baobrien/coin-thing/pcb/coin-thingus/coin-trunker.pdf

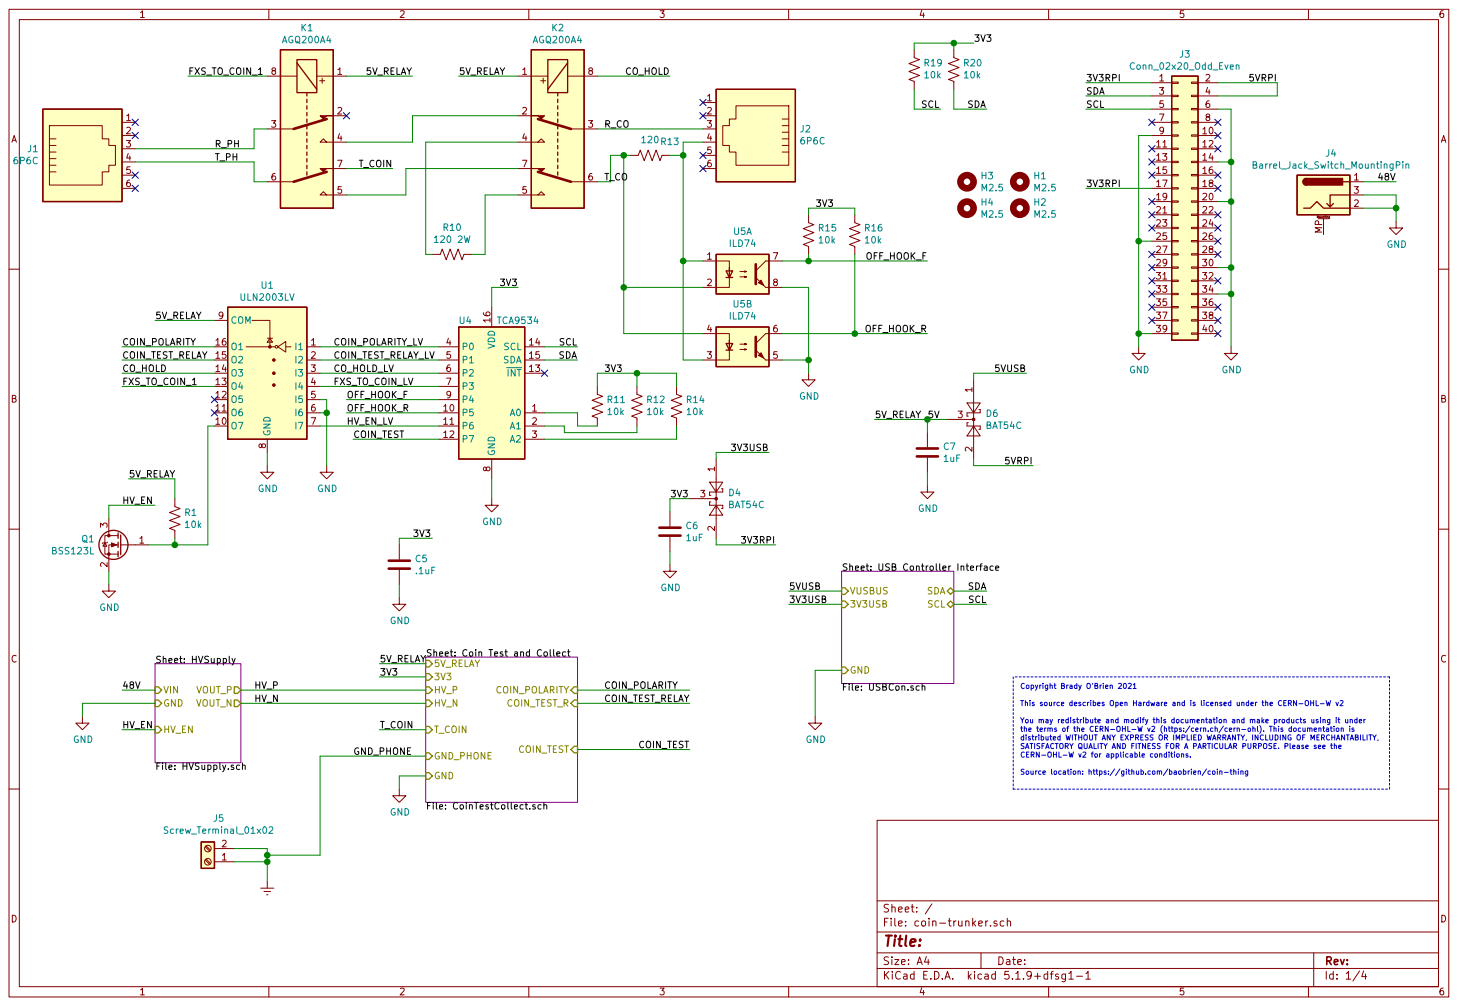
[picture p1: page 1]

Sheet: USB Controller Interface File: USBCon.sch VUSBUS GND

SCL Sheet: Coin Test and Collect File: CoinTestCollect.sch HV_P HV_N

Id: 1/4 Title: File: coin-trunker.sch Sheet: / Sheet: HVSupply

Copyright Brady OBrien 2021 This source describes Open Hardware and is licensed under the CERN-OHL-W v2 You may redistribute and modify this documentation and make products using it under

the terms of the CERN-OHL-W v2 (https:/cern.ch/cern-ohl). This documentation is distributed WITHOUT ANY EXPRESS OR IMPLIED WARRANTY, INCLUDING OF MERCHANTABILITY, SATISFACTORY QUALITY AND FITNESS FOR A PARTICULAR PURPOSE. Please see the CERN-OHL-W v2 for applicable conditions. Source location: https://github.com/baobrien/coin-thing

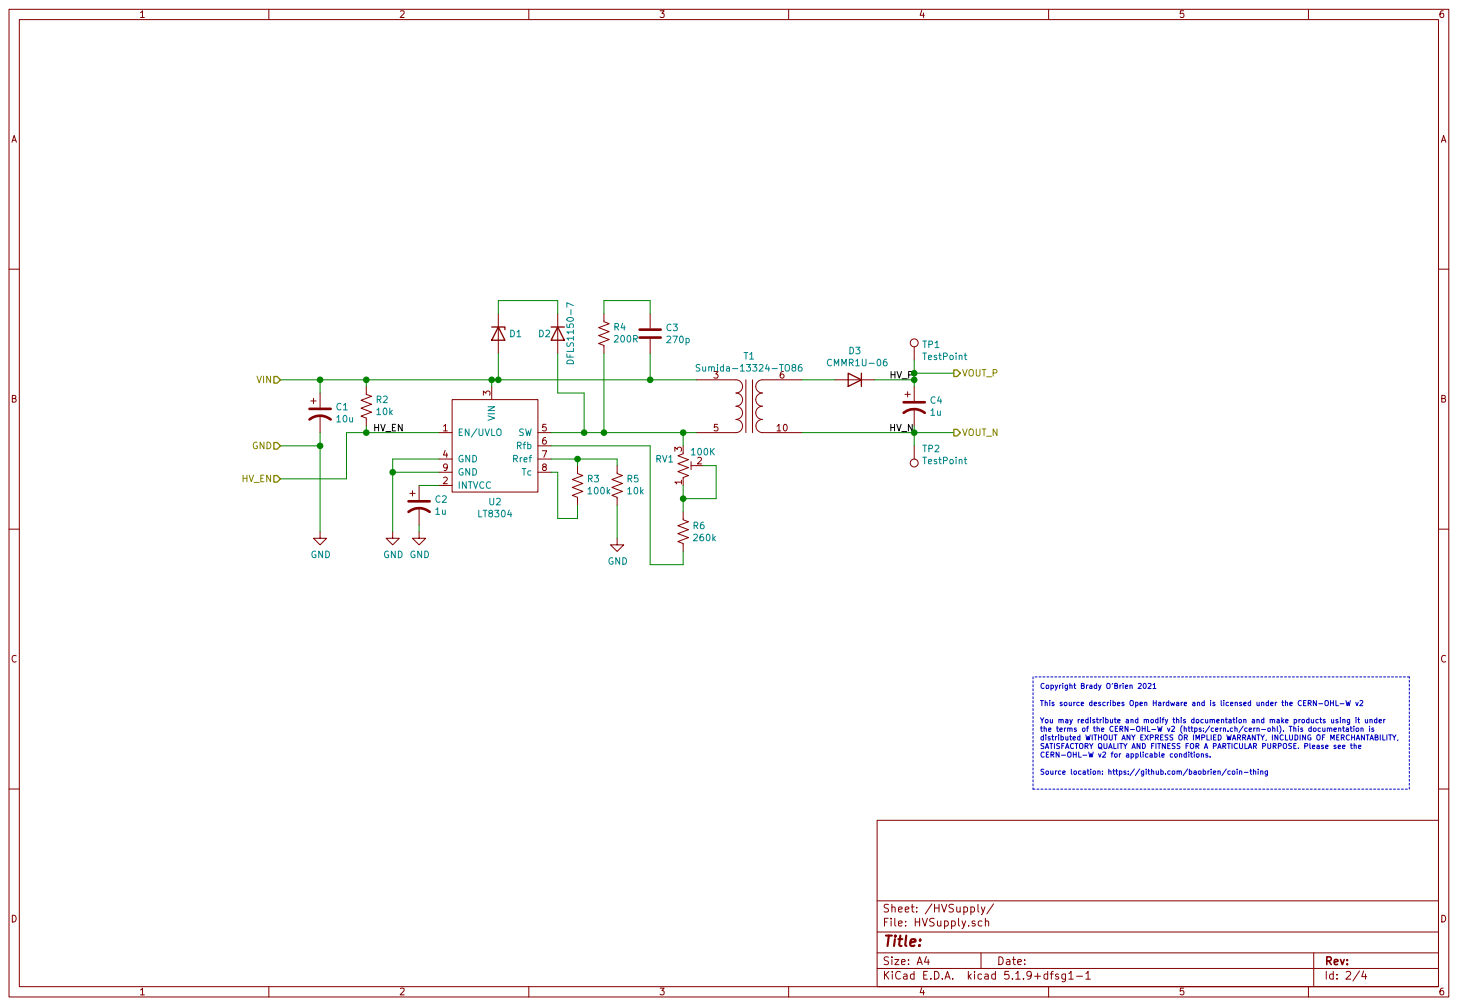
[picture p2: page 2]

3 GND 4 SW 5 Rfb 6 Rref 7 Tc 8 GND 9 U2

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

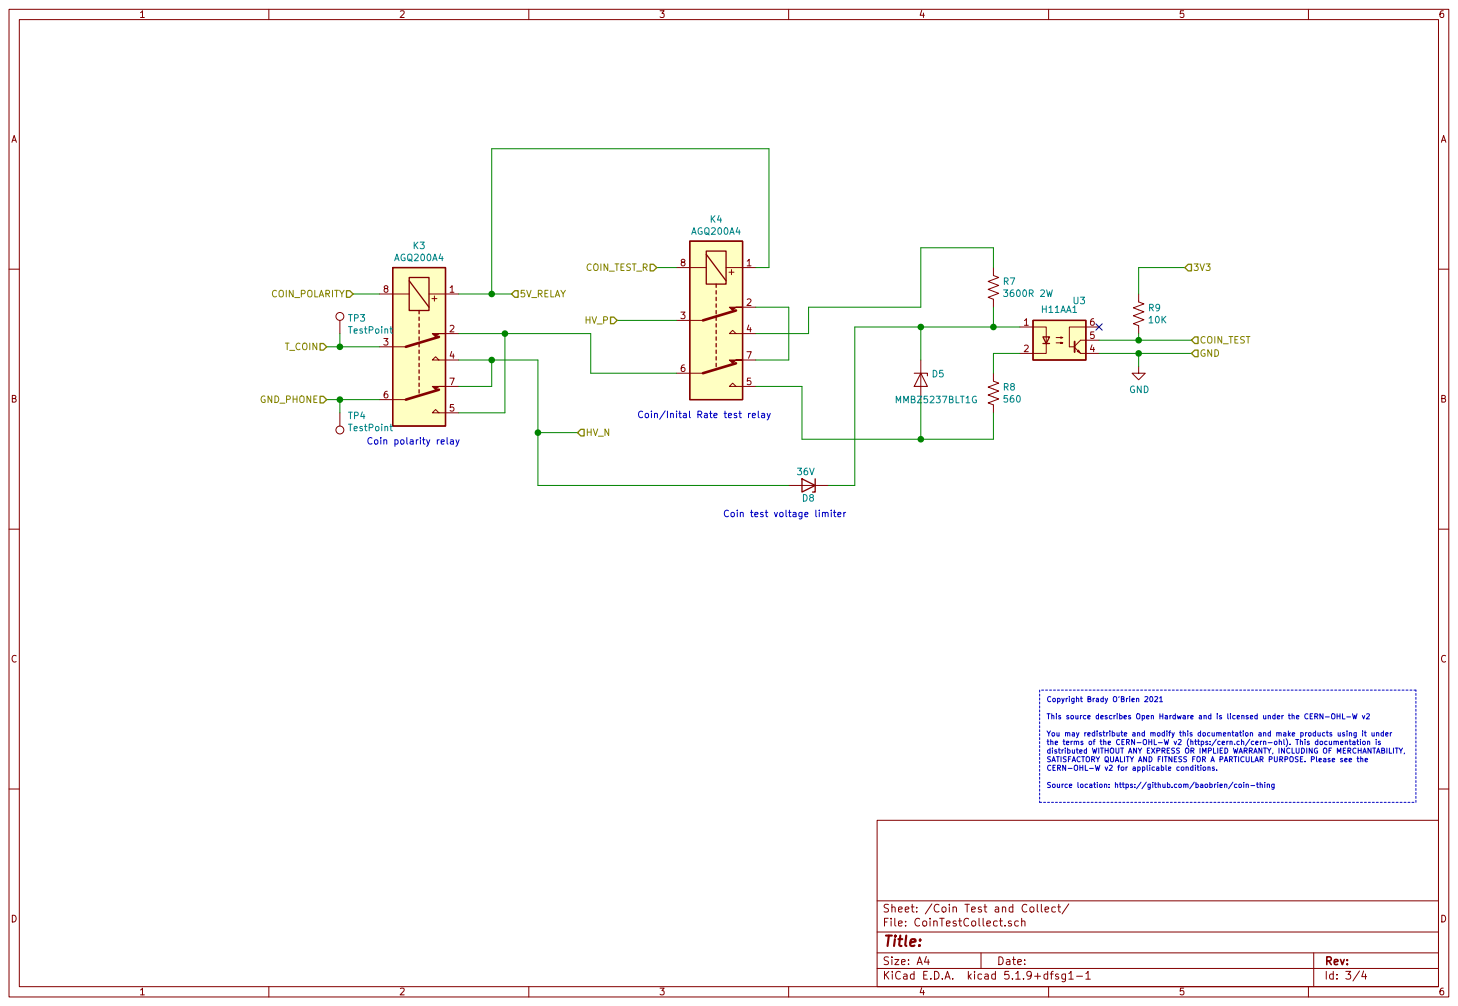
[picture p3: page 3]

Coin/Inital Rate test relay

the terms of the CERN-OHL-W v2 (https:/cern.ch/cern-ohl). This documentation is distributed WITHOUT ANY EXPRESS OR IMPLIED WARRANTY, INCLUDING OF MERCHANTABILITY, SATISFACTORY QUALITY AND FITNESS FOR A PARTICULAR PURPOSE. Please see the CERN-OHL-W v2 for applicable conditions. Source location: https://github.com/baobrien/coin-thing Coin test voltage limiter

Id: 3/4 Title: File: CoinTestCollect.sch Sheet: /Coin Test and Collect/

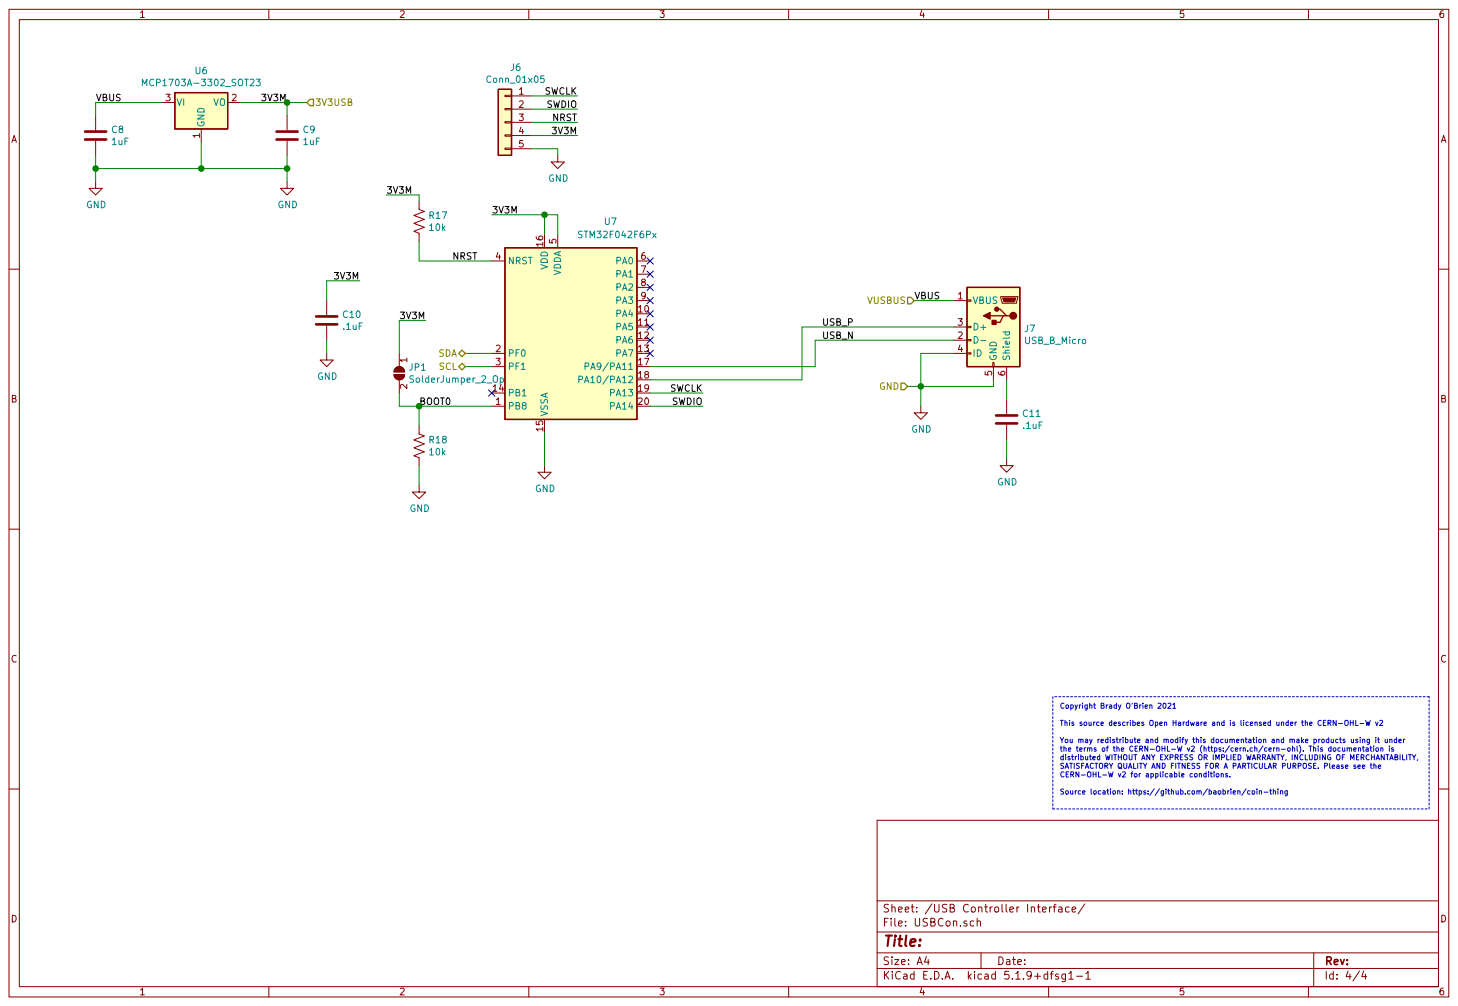
[picture p4: page 4]
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

Id: 4/4 Title: File: USBCon.sch Sheet: /USB Controller Interface/
