baobrien/coin-thing/(list of files, drawings)

Other design files:
pcb/coin-thingus/coin-trunker.dsn
