baobrien/coin-thing/pcb/coin-thingus/coin-trunker.kicad_pcb

## KiCad design pcb/coin-thingus/coin-trunker.kicad_pcb (2021-04-16)

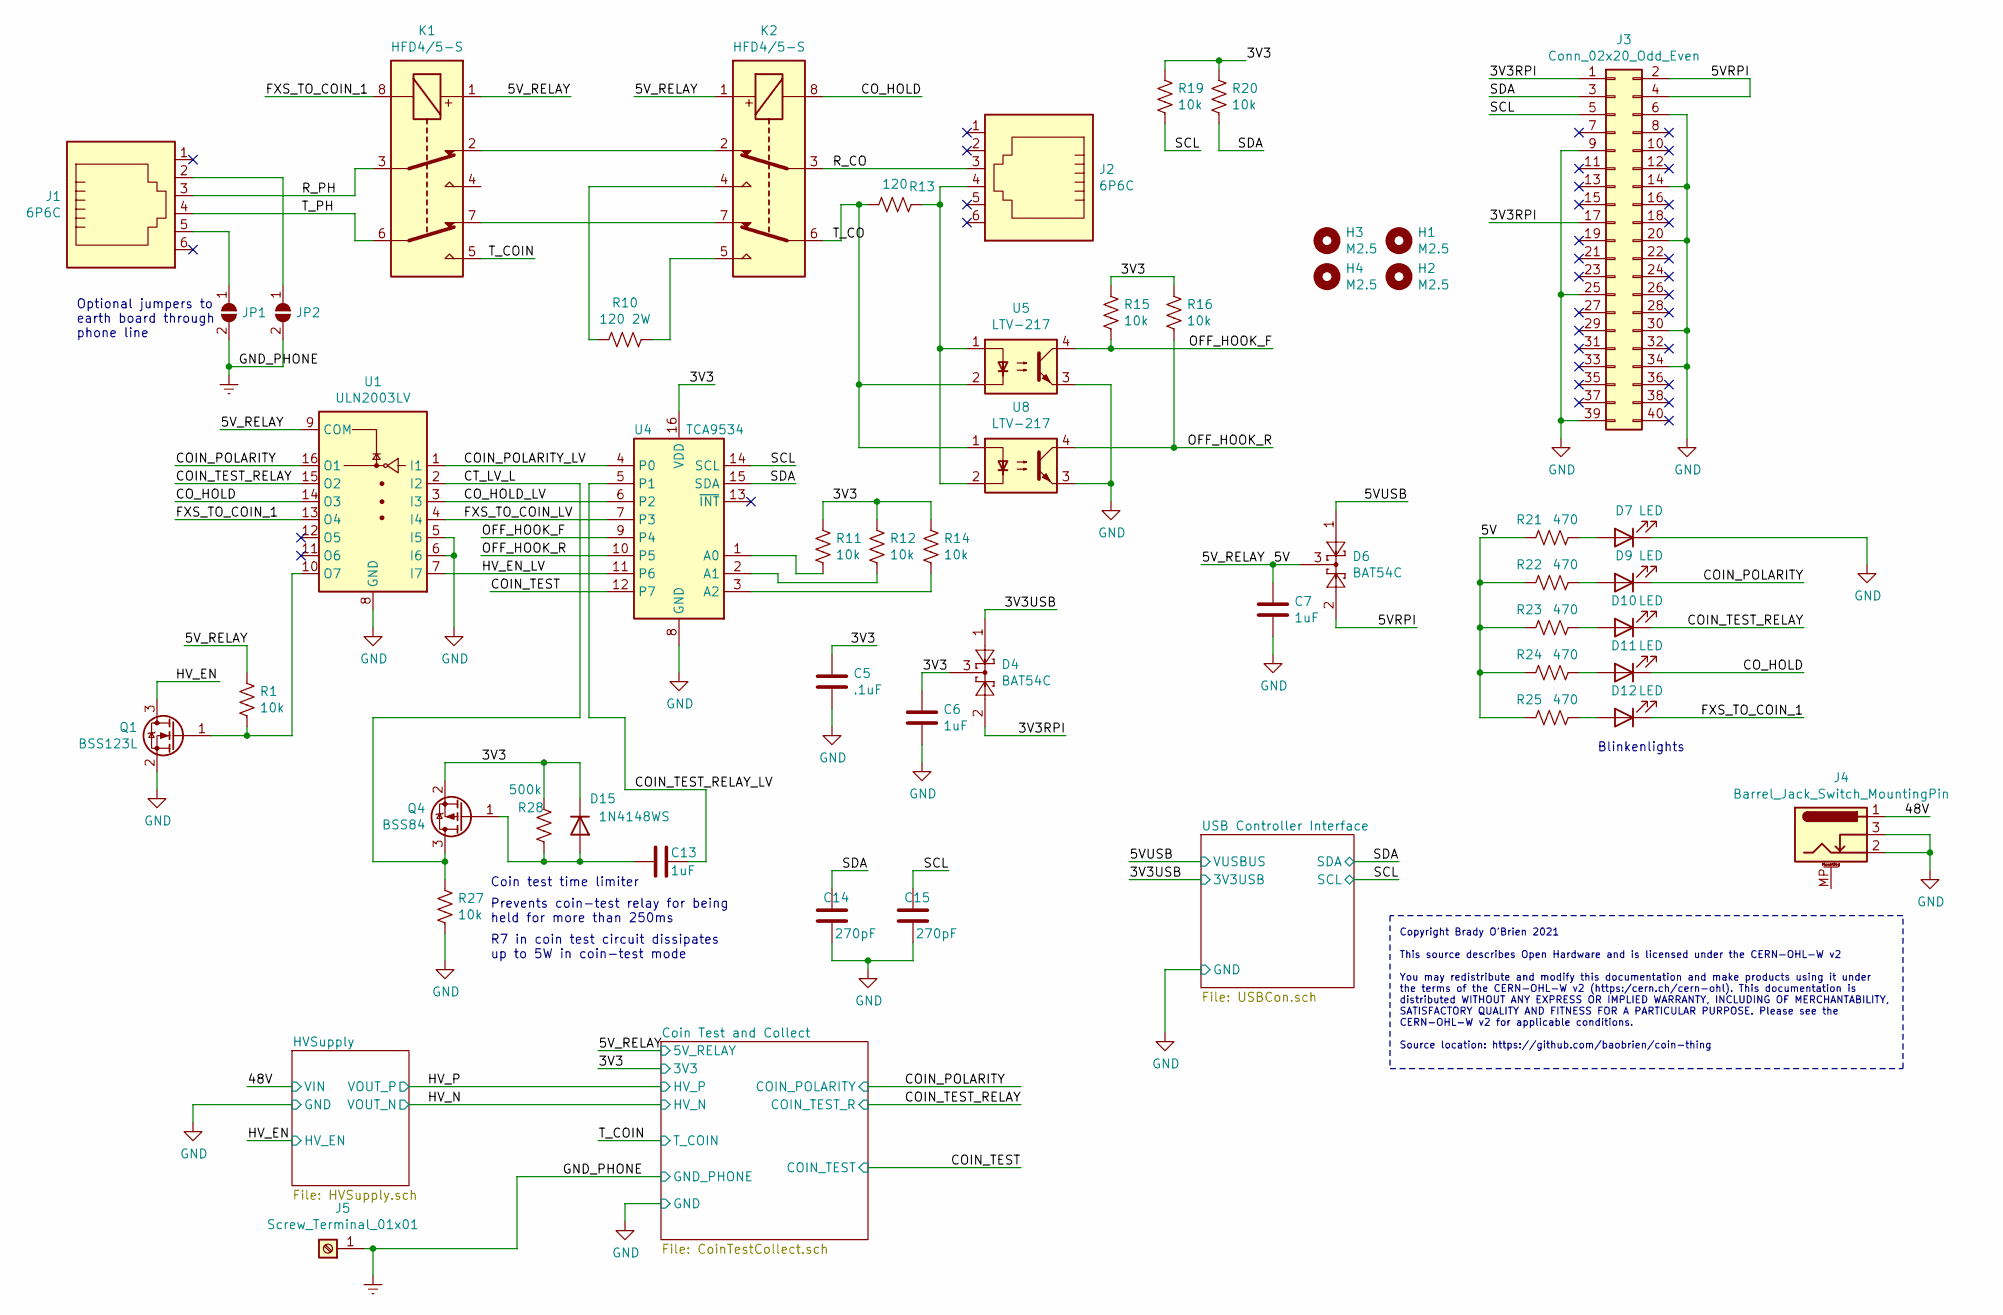
[picture p5: schematic coin-trunker.sch]

Parts:
C5: .1uF; C_0603_1608Metric
C6, C7, C13: 1uF; C_0603_1608Metric
C14, C15: 270pF; C_0603_1608Metric
D4, D6: BAT54C; SOT-23
D7, D9, D10, D11, D12: LED; LED_0603_1608Metric
D15: 1N4148WS; D_SOD-323_HandSoldering
H1, H2, H3, H4: M2.5; MountingHole_2.7mm_M2.5_Pad
J1, J2: 6P6C; RJ12_Molex_95501-6669
J3: Conn_02x20_Odd_Even; PinHeader_2x20_P2.54mm_Vertical
J4: Barrel_Jack_Switch_MountingPin; BarrelJack_CUI_PJ-102AH_Horizontal; Part PJ-102AH
J5: Screw_Terminal_01x01; screw_block_m3_5x7
JP1, JP2: SolderJumper_2_Open; SolderJumper-2_P1.3mm_Open_TrianglePad1.0x1.5mm
K1, K2: HFD4/5-S; Relay_DPDT_Omron_G6K-2F-Y
Q1: BSS123L; SOT-23
Q4: BSS84; SOT-23
R1, R11, R12, R14, R15, R16, R19, R20, R27: 10k; R_0402_1005Metric
R10: 120 2W; R_1206_3216Metric
R13: 120; R_0402_1005Metric
R21, R22, R23, R24, R25: 470; R_0402_1005Metric
R28: 500k; R_0402_1005Metric
U1: ULN2003LV; SOIC-16_3.9x9.9mm_P1.27mm
U4: TCA9534; TSSOP-16_4.4x5mm_P0.65mm
U5, U8: LTV-217; SOP-4_4.4x2.6mm_P1.27mm

Connections:
/3V3: C5.1, C6.1, D4.3, D15.1 (K), Q4.2 (S), R11.2, R12.2, R14.2, R15.2, R16.2, R19.2, R20.2, R28.1, U4.16 (VDD); also elsewhere on the board
/3V3RPI: D4.2, J3.1, J3.17
/3V3USB: D4.1; also elsewhere on the board
/5V: C7.1, D6.3, K1.1, K2.1, R1.1, R21.2, R22.2, R23.2, R24.2, R25.2, U1.9 (COM); also elsewhere on the board
/5VRPI: D6.2, J3.2, J3.4
/5VUSB: D6.1; also elsewhere on the board
/48V: J4.1; also elsewhere on the board
/COIN_POLARITY: D9.1 (K), U1.16 (O1); also elsewhere on the board
/COIN_POLARITY_LV: U1.1 (I1), U4.4 (P0)
/COIN_TEST: U4.12 (P7); also elsewhere on the board
/COIN_TEST_RELAY: D10.1 (K), U1.15 (O2); also elsewhere on the board
/COIN_TEST_RELAY_LV: C13.1, U4.5 (P1)
/CO_HOLD: D11.1 (K), K2.8, U1.14 (O3)
/CO_HOLD_LV: U1.3 (I3), U4.6 (P2)
/CT_LV_L: Q4.3 (D), R27.1, U1.2 (I2)
/FXS_TO_COIN_1: D12.1 (K), K1.8, U1.13 (O4)
/FXS_TO_COIN_LV: U1.4 (I4), U4.7 (P3)
/HV_EN: Q1.3 (D); also elsewhere on the board
/HV_EN_LV: U1.7 (I7), U4.11 (P6)
/OFF_HOOK_F: R15.1, U4.9 (P4), U5.4
/OFF_HOOK_R: R16.1, U4.10 (P5), U8.4
/R_CO: J2.3, K2.3
/R_PH: J1.3, K1.3
/SCL: C15.2, J3.5, R19.1, U4.14 (SCL); also elsewhere on the board
/SDA: C14.2, J3.3, R20.1, U4.15 (SDA); also elsewhere on the board
/T_CO: K2.6, R13.1, U5.2, U8.1
/T_COIN: K1.5; also elsewhere on the board
/T_PH: J1.4, K1.6
Earth: J5.1, JP1.2 (B), JP2.2 (B); also elsewhere on the board
GND: C5.2, C6.2, C7.2, C14.1, C15.1, D7.1 (K), J3.6, J3.9, J3.14, J3.20, J3.25, J3.30, J3.34, J3.39, J4.2, J4.3, Q1.2 (S), R27.2, U1.5 (I5), U1.6 (I6), U1.8 (GND), U4.8 (GND), U5.3, U8.3; also elsewhere on the board
unnamed: C13.2, D15.2 (A), Q4.1 (G), R28.2
unnamed: D7.2 (A), R21.1
unnamed: D9.2 (A), R22.1
unnamed: D10.2 (A), R23.1
unnamed: D11.2 (A), R24.1
unnamed: D12.2 (A), R25.1
unnamed: J1.2, JP2.1 (A)
unnamed: J1.5, JP1.1 (A)
unnamed: J2.4, R13.2, U5.1, U8.2
unnamed: K1.2, K2.2
unnamed: K1.7, K2.7
unnamed: K2.4, R10.2
unnamed: K2.5, R10.1
unnamed: Q1.1 (G), R1.2, U1.10 (O7)
unnamed: R11.1, U4.1 (A0)
unnamed: R12.1, U4.2 (A1)
unnamed: R14.1, U4.3 (A2)

Notes on the sheet:
Copyright Brady O’Brien 2021 This source describes Open Hardware and is licensed under the CERN-OHL-W v2 You may redistribute and modify this documentation and make products using it under the terms of the CERN-OHL-W v2 (https:/cern.ch/cern-ohl). This documentation is distributed WITHOUT ANY EXPRES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
Blinkenlights
Optional jumpers to earth board through phone line
Coin test time limiter
Prevents coin-test relay for being held for more than 250ms
R7 in coin test circuit dissipates up to 5W in coin-test mode

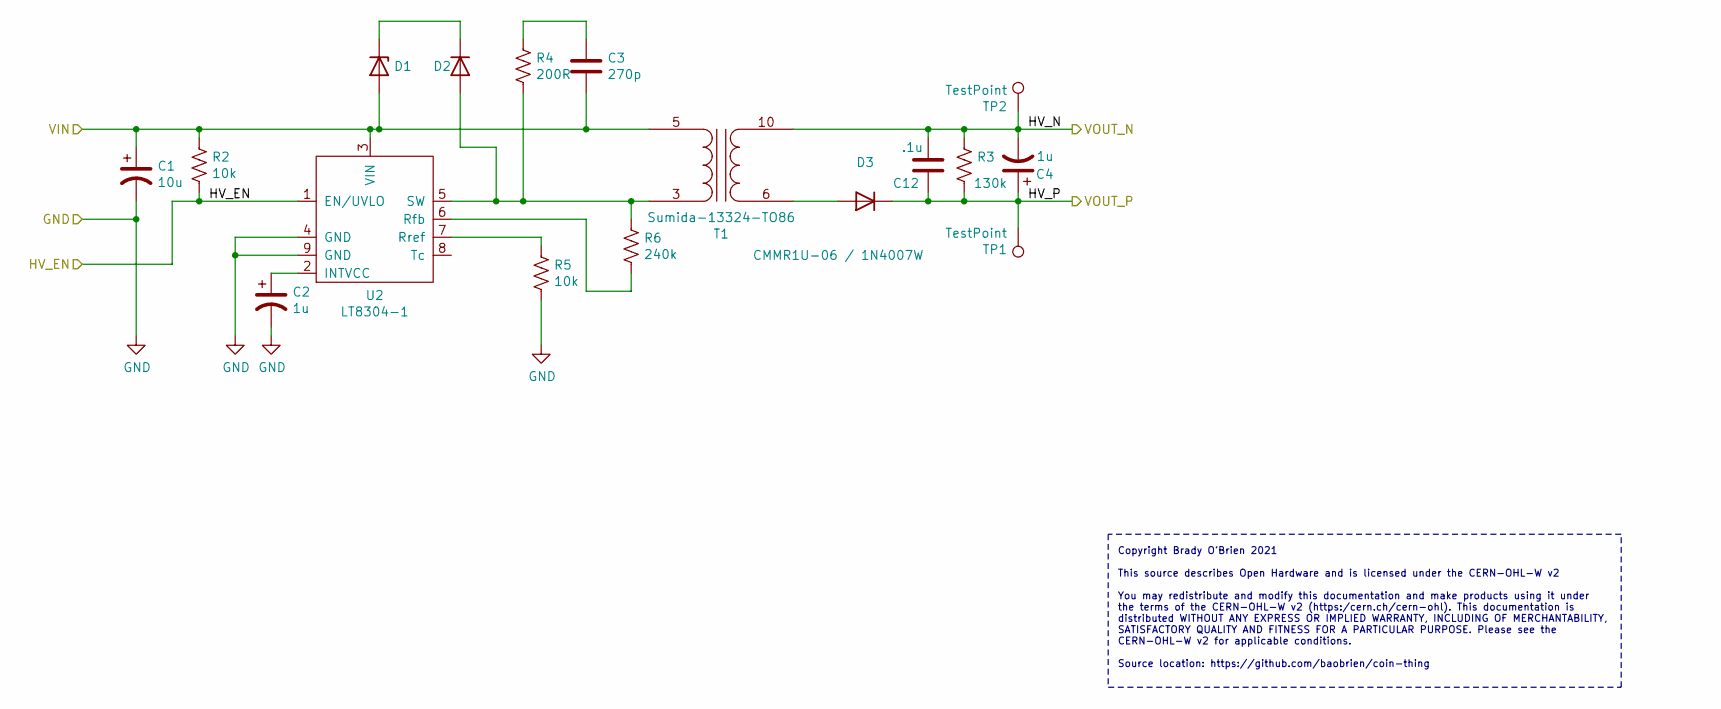
[picture p6: schematic HVSupply.sch]

Parts:
C1: 10u; C_1210_3225Metric
C2: 1u; C_0603_1608Metric
C3: 270p; C_0603_1608Metric
C4: 1u; CP_Radial_D6.3mm_P2.50mm
C12: .1u; C_1210_3225Metric
D1: D_Zener; D_SMA
D2: DFLS1150-7; D_PowerDI-123
D3: CMMR1U-06 / 1N4007W; D_SOD-123F; Part CMMR1U-06
R2, R5: 10k; R_0402_1005Metric
R3: 130k; R_0402_1005Metric
R4: 200R; R_0402_1005Metric
R6: 240k; R_0603_1608Metric
T1: Sumida-13324-TO86; SUMIDA-S-074-1511
TP1, TP2: TestPoint; Pin_D1.0mm_L10.0mm
U2: LT8304-1; TI_SO-PowerPAD-8

Connections:
/48V: C1.1, C3.2, D1.2 (A), R2.2, T1.5 (AB), U2.3 (VIN); also elsewhere on the board
/HV_EN: R2.1, U2.1 (EN/UVLO); also elsewhere on the board
/HV_N: C4.2, C12.1, R3.1, T1.10 (SA), TP2.1; also elsewhere on the board
/HV_P: C4.1, C12.2, D3.1 (K), R3.2, TP1.1; also elsewhere on the board
GND: C1.2, C2.2, R5.1, U2.4 (GND), U2.9 (GND); also elsewhere on the board
unnamed: C2.1, U2.2 (INTVCC)
unnamed: C3.1, R4.2
unnamed: D1.1 (K), D2.1 (K)
unnamed: D2.2 (A), R4.1, R6.1, T1.3 (AA), U2.5 (SW)
unnamed: D3.2 (A), T1.6 (SB)
unnamed: R5.2, U2.7 (Rref)
unnamed: R6.2, U2.6 (Rfb)

Notes on the sheet:
Copyright Brady O’Brien 2021 This source describes Open Hardware and is licensed under the CERN-OHL-W v2 You may redistribute and modify this documentation and make products using it under the terms of the CERN-OHL-W v2 (https:/cern.ch/cern-ohl). This documentation is distributed WITHOUT ANY EXPRES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

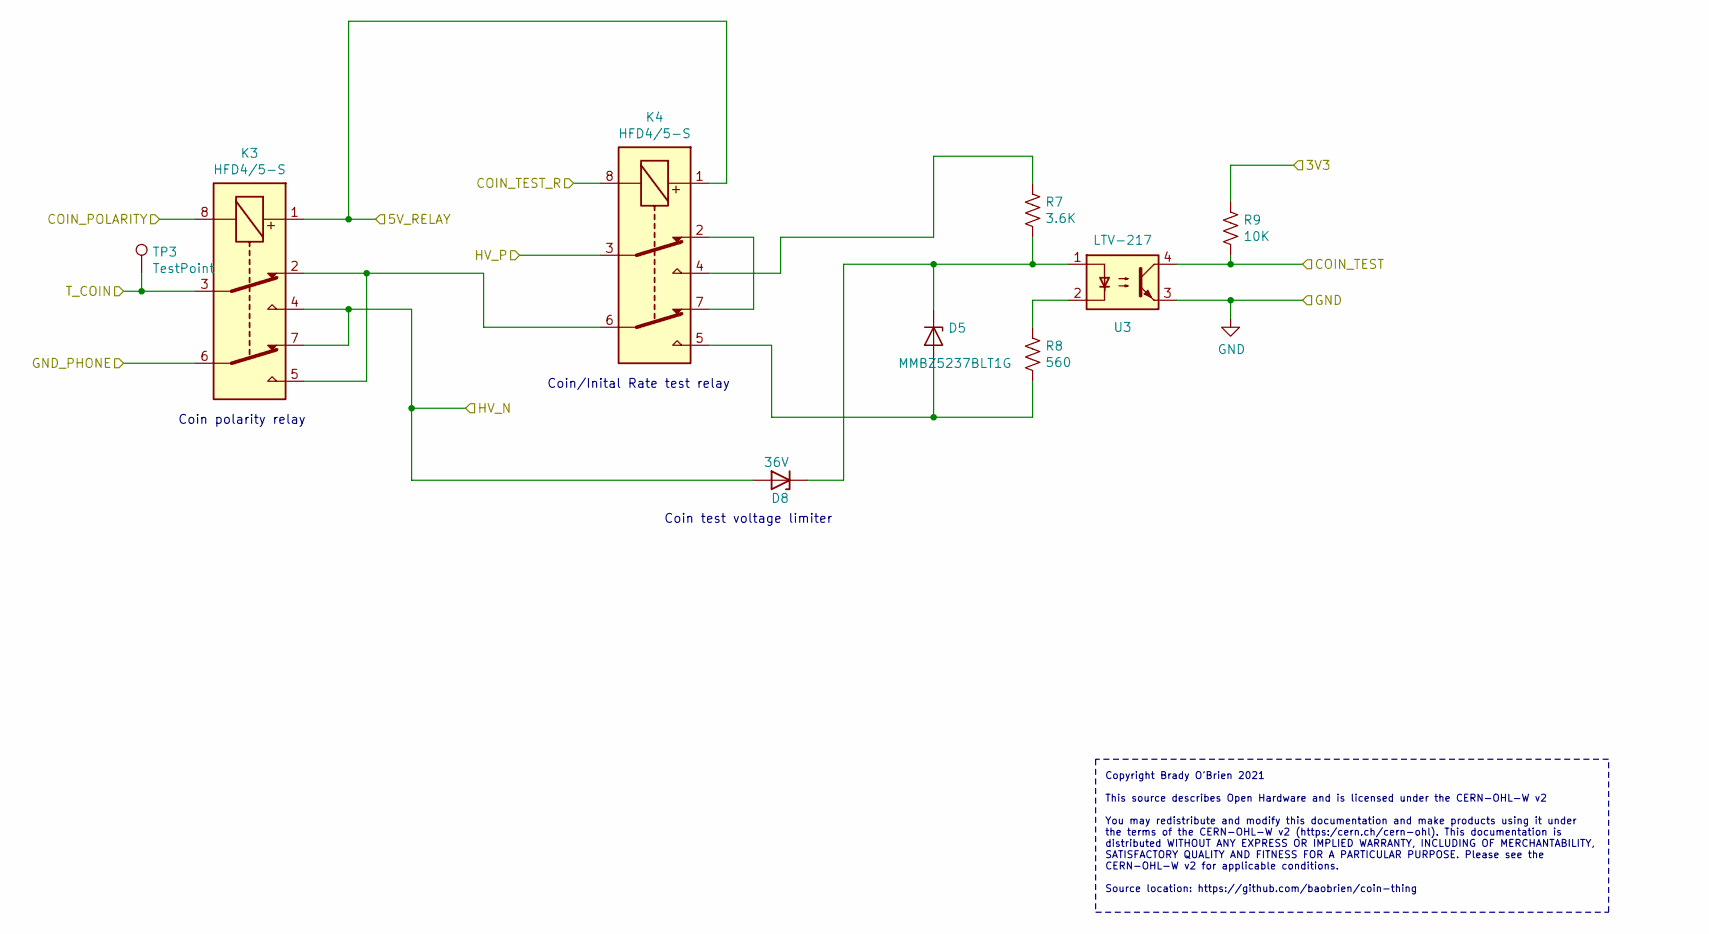
[picture p7: schematic CoinTestCollect.sch]

Parts:
D5: MMBZ5237BLT1G; SOT-23; Part MMBZ5237BLT1G
D8: 36V; D_SOD-323_HandSoldering; Part BZX384-C36
K3, K4: HFD4/5-S; Relay_DPDT_Omron_G6K-2F-Y
R7: 3.6K; R_2010_5025Metric; Part 2010W2J0392T4S
R8: 560; R_0603_1608Metric
R9: 10K; R_0402_1005Metric
TP3: TestPoint; Pin_D1.0mm_L10.0mm
U3: LTV-217; SOP-4_4.4x2.6mm_P1.27mm

Connections:
/3V3: R9.1; also elsewhere on the board
/5V: K3.1, K4.1; also elsewhere on the board
/COIN_POLARITY: K3.8; also elsewhere on the board
/COIN_TEST: R9.2, U3.4; also elsewhere on the board
/COIN_TEST_RELAY: K4.8; also elsewhere on the board
/HV_N: D8.2 (A), K3.4, K3.7; also elsewhere on the board
/HV_P: K4.3; also elsewhere on the board
/T_COIN: K3.3, TP3.1; also elsewhere on the board
Earth: K3.6; also elsewhere on the board
GND: U3.3; also elsewhere on the board
unnamed: D5.1 (A), K4.5, R8.2
unnamed: D5.3 (K), D8.1 (K), R7.2, U3.1
unnamed: K3.2, K3.5, K4.6
unnamed: K4.2, K4.7
unnamed: K4.4, R7.1
unnamed: R8.1, U3.2

Notes on the sheet:
Coin polarity relay
Coin/Inital Rate test relay
Coin test voltage limiter
Copyright Brady O’Brien 2021 This source describes Open Hardware and is licensed under the CERN-OHL-W v2 You may redistribute and modify this documentation and make products using it under the terms of the CERN-OHL-W v2 (https:/cern.ch/cern-ohl). This documentation is distributed WITHOUT ANY EXPRES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

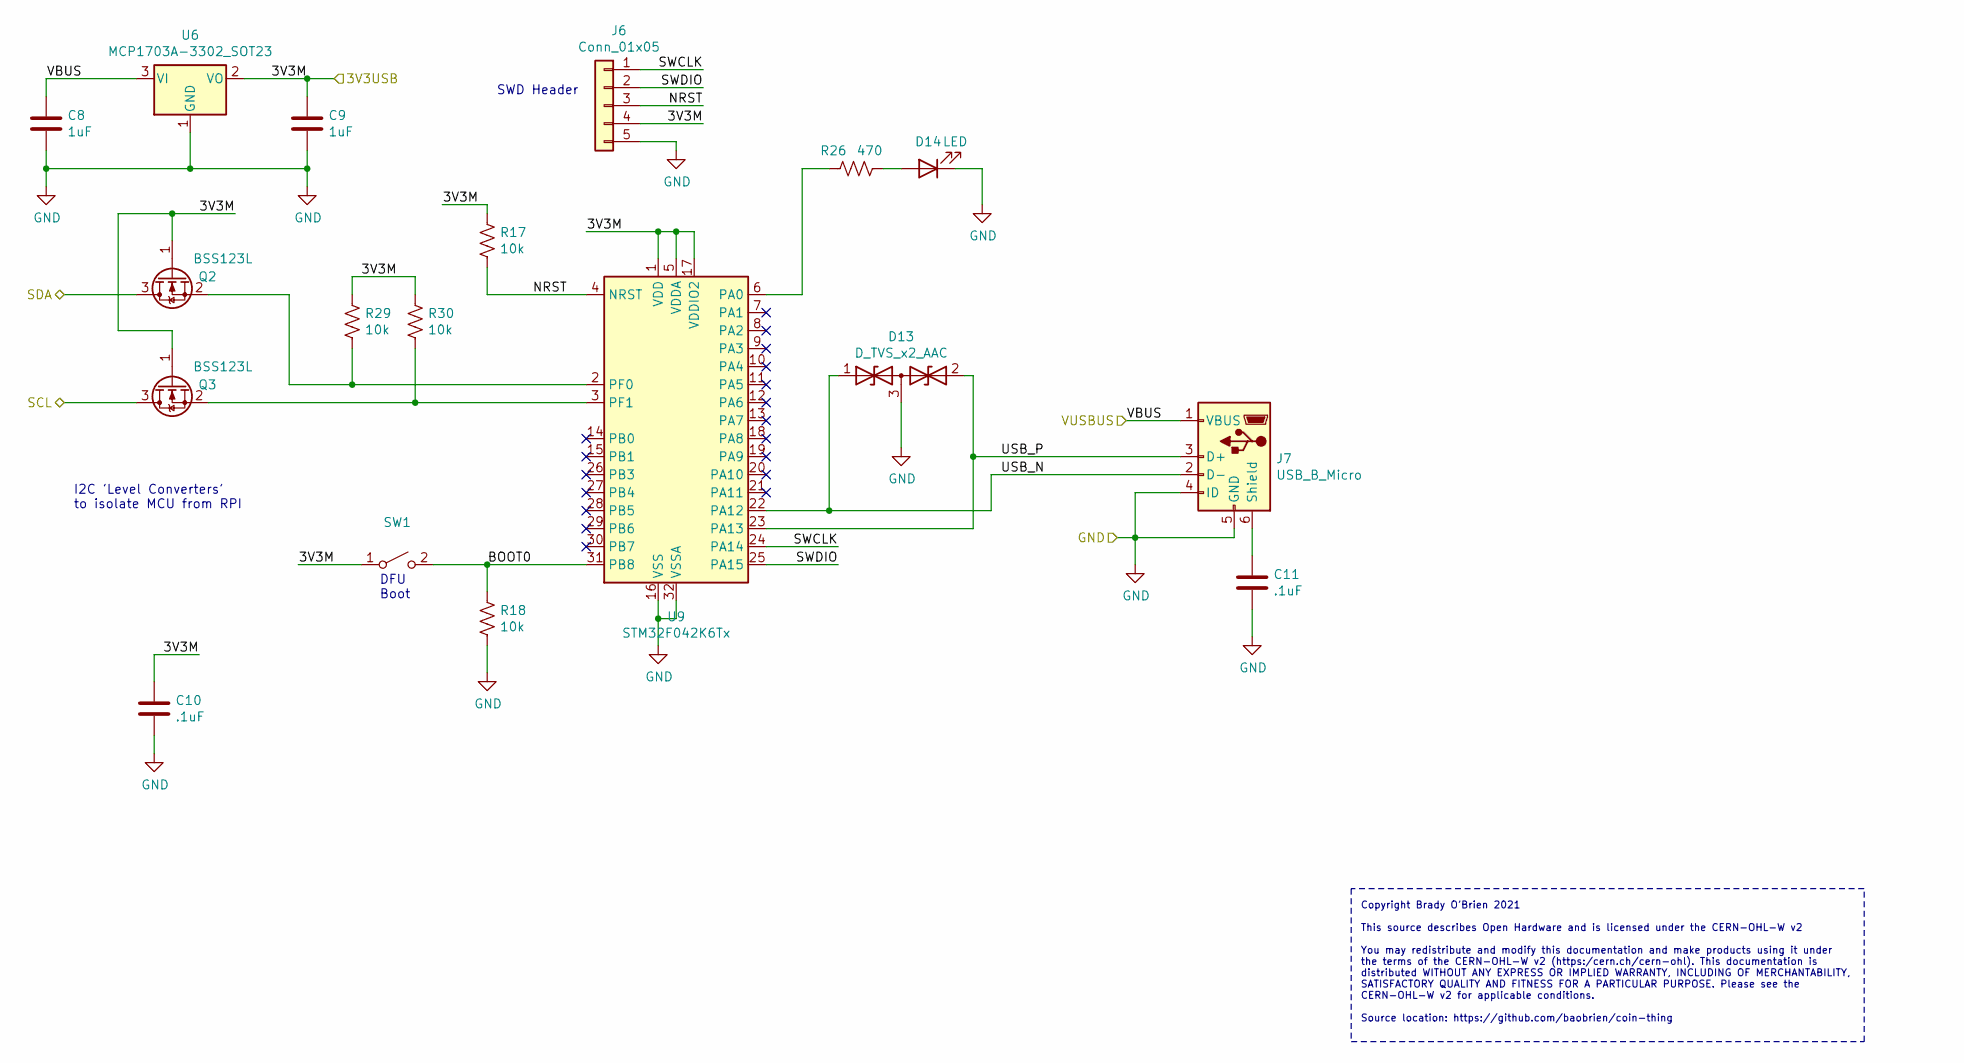
[picture p8: schematic USBCon.sch]

Parts:
C8, C9: 1uF; C_0603_1608Metric
C10, C11: .1uF; C_0603_1608Metric
D13: D_TVS_x2_AAC; SOT-23
D14: LED; LED_0603_1608Metric
J6: Conn_01x05; PinHeader_1x05_P2.54mm_Vertical
J7: USB_B_Micro; USB_Micro-B_Molex-105017-0001; Part U254-051T-4BH23-S2B
Q2, Q3: BSS123L; SOT-23
R17, R18, R29, R30: 10k; R_0402_1005Metric
R26: 470; R_0402_1005Metric
SW1: TS-1187A-C-E-B; SW_SPST_TL3342; Part TS-1187A-C-E-B
U6: MCP1703A-3302_SOT23; SOT-23; Part Alt SC662K-3.3V
U9: STM32F042K6Tx; LQFP-32_7x7mm_P0.8mm

Connections:
/3V3USB: C9.1, C10.1, J6.4, Q2.1 (G), Q3.1 (G), R17.1, R29.1, R30.1, SW1.1 (A), U6.2 (VO), U9.1 (VDD), U9.5 (VDDA), U9.17 (VDDIO2); also elsewhere on the board
/5VUSB: C8.1, J7.1 (VBUS), U6.3 (VI); also elsewhere on the board
/SCL: Q3.3 (D); also elsewhere on the board
/SDA: Q2.3 (D); also elsewhere on the board
/USB Controller Interface/BOOT0: R18.1, SW1.2 (B), U9.31 (PB8)
/USB Controller Interface/NRST: J6.3, R17.2, U9.4 (NRST)
/USB Controller Interface/SWCLK: J6.1, U9.24 (PA14)
/USB Controller Interface/SWDIO: J6.2, U9.25 (PA15)
/USB Controller Interface/USB_N: D13.1 (A1), J7.2 (D-), U9.22 (PA12)
/USB Controller Interface/USB_P: D13.2 (A2), J7.3 (D+), U9.23 (PA13)
GND: C8.2, C9.2, C10.2, C11.2, D13.3 (common), D14.1 (K), J6.5, J7.4 (ID), J7.5 (GND), R18.2, U6.1 (GND), U9.16 (VSS), U9.32 (VSSA); also elsewhere on the board
unnamed: C11.1, J7.6 (Shield)
unnamed: D14.2 (A), R26.1
unnamed: Q2.2 (S), R29.2, U9.2 (PF0)
unnamed: Q3.2 (S), R30.2, U9.3 (PF1)
unnamed: R26.2, U9.6 (PA0)

Notes on the sheet:
Copyright Brady O’Brien 2021 This source describes Open Hardware and is licensed under the CERN-OHL-W v2 You may redistribute and modify this documentation and make products using it under the terms of the CERN-OHL-W v2 (https:/cern.ch/cern-ohl). This documentation is distributed WITHOUT ANY EXPRES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
DFU Boot
SWD Header
I2C 'Level Converters' to isolate MCU from RPI

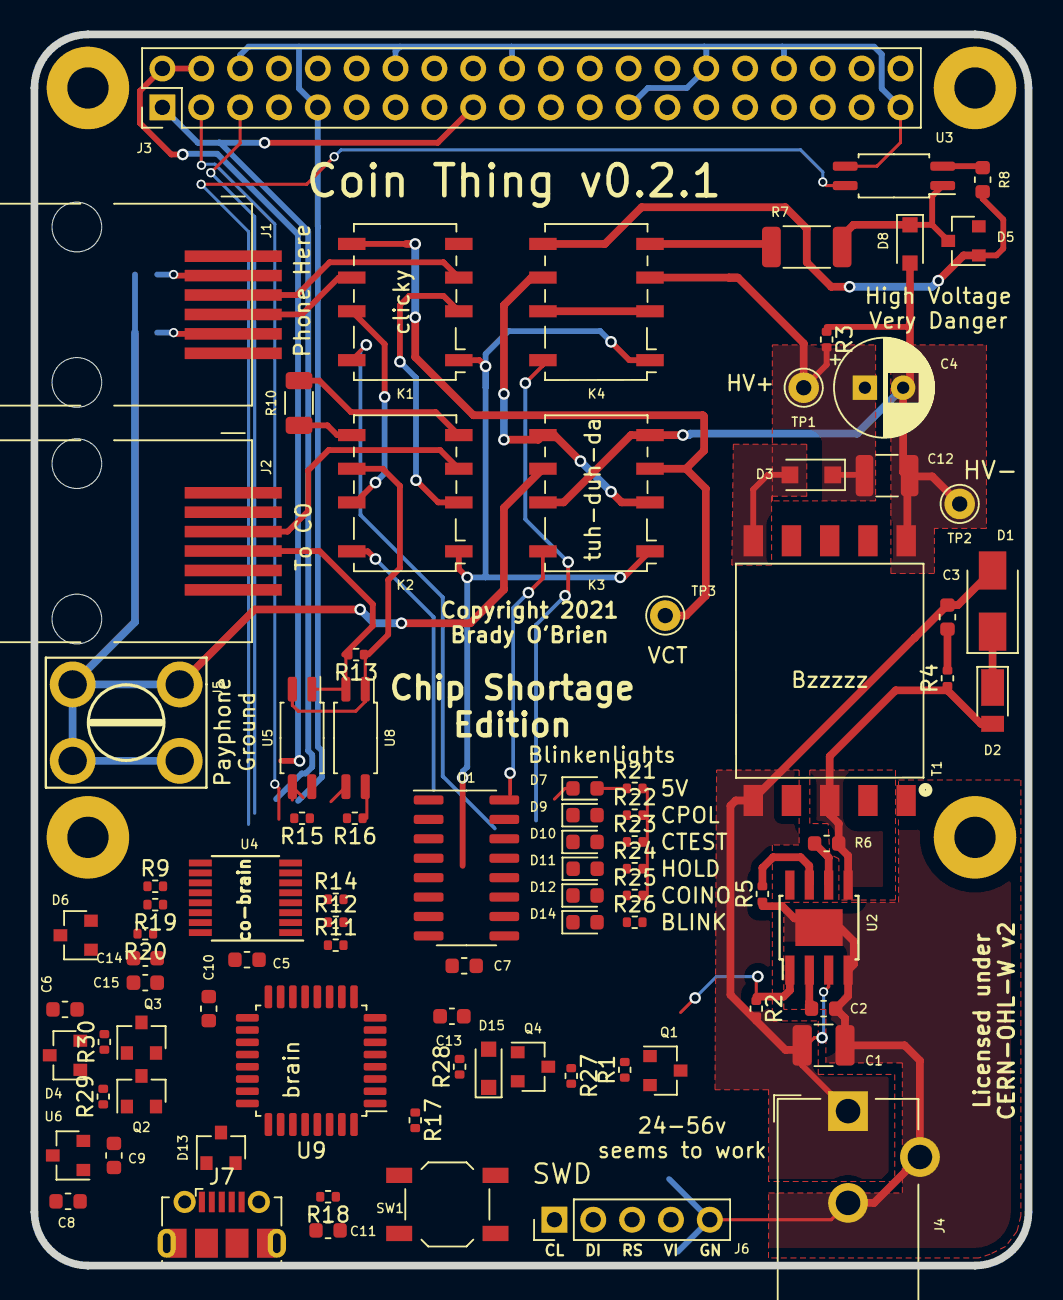
[picture p9: board coin-trunker.kicad_pcb from above]

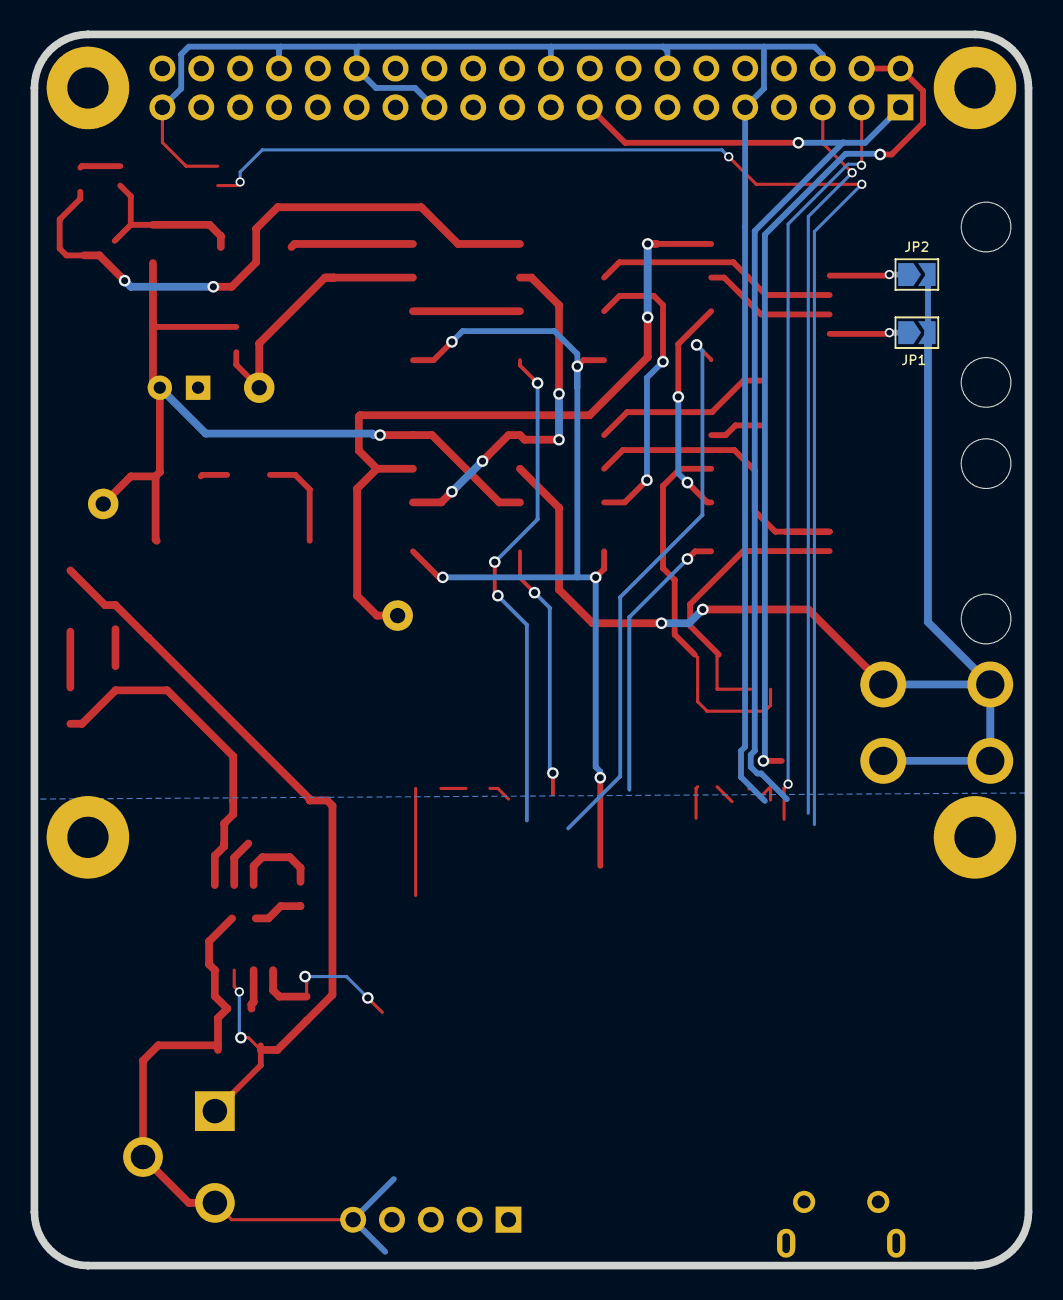
[picture p10: board coin-trunker.kicad_pcb from below]

Board: 2 copper layers, 65.0 x 80.5 mm, 94 parts (2 on the bottom side), 73 nets.
