baobrien/coin-thing/pcb/coin-thingus/hvsupply-test/hv-supply-test/hv-supply-test.kicad_pcb

## KiCad design pcb/coin-thingus/hvsupply-test/hv-supply-test/hv-supply-test.kicad_pcb (2021-03-13)

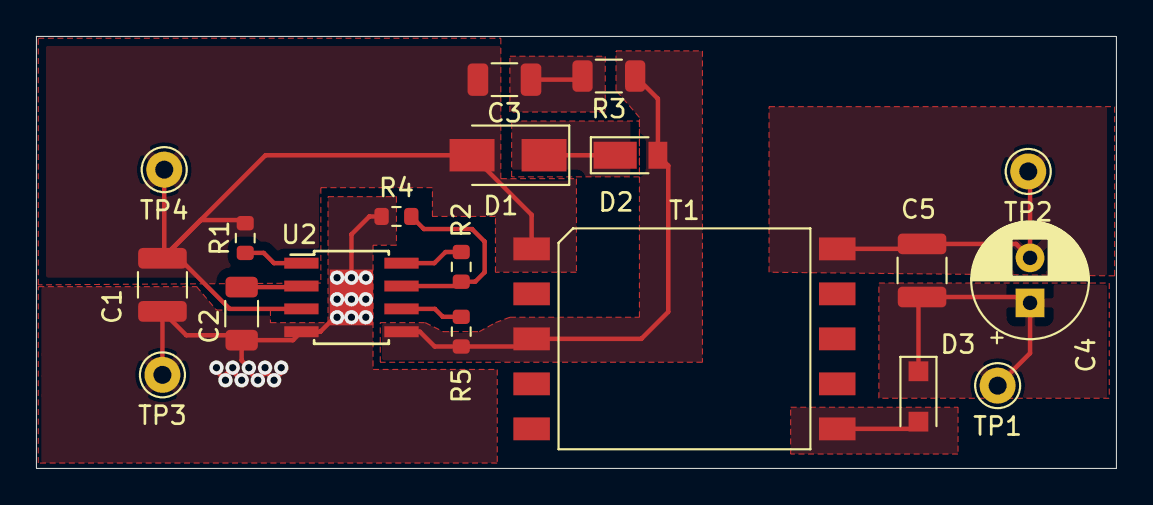
[picture p11: board hv-supply-test.kicad_pcb from above]

Board: 2 copper layers, 60.0 x 24.0 mm, 19 parts (0 on the bottom side), 13 nets.

Parts:
C1: 10u; C_1210_3225Metric
C2: 1u; C_1206_3216Metric
C3: 270p; C_1206_3216Metric
C4: 1u; CP_Radial_D6.3mm_P2.50mm
C5: .1u; C_1210_3225Metric
D1: D_Zener; D_SMA
D2: DFLS1150-7; D_PowerDI-123
D3: CMMR1U-06; D_SOD-123F
R1, R4: 10k; R_0603_1608Metric
R2: 100k; R_0603_1608Metric
R3: 200R; R_1206_3216Metric
R5: 200k; R_0603_1608Metric
T1: Sumida-13324-TO86; SUMIDA-S-074-1511
TP1, TP2, TP3, TP4: TestPoint; Pin_D1.0mm_L10.0mm
U2: LT8304; TI_SO-PowerPAD-8

Connections:
/HV_EN: R1.1, U2.1
/VIN: C1.1, C3.2, D1.2, R1.2, T1.5, TP4.1, U2.3
/VOUT_N: C4.2, C5.2, T1.6, TP2.1
/VOUT_P: C4.1, C5.1, D3.1, TP1.1
GND: C1.2, C2.2, R4.1, TP3.1, U2.4, U2.9
unnamed: C2.1, U2.2
unnamed: C3.1, R3.2
unnamed: D1.1, D2.1
unnamed: D2.2, R3.1, R5.1, T1.3, U2.5
unnamed: D3.2, T1.10
unnamed: R2.1, U2.8
unnamed: R2.2, R4.2, U2.7
unnamed: R5.2, U2.6
