baobrien/coin-thing/(commit log)

2021-01-27 Release version 0.1.0
    [USBCon.sch, coin-trunker.csv, coin-trunker.kicad_pcb]
2021-02-14 v0.1 release
    [CoinTestCollect.sch, HVSupply.sch, USBCon.sch, coin-trunker.csv, coin-trunker.kicad_pcb, coin-trunker.sch]
2021-02-14 Add CERN-OHL-W v2 license
    [CoinTestCollect.sch, HVSupply.sch, USBCon.sch, coin-trunker.kicad_pcb, coin-trunker.sch]
2021-02-14 Some work towards v0.2
    [CoinTestCollect.sch, HVSupply.sch, USBCon.sch, coin-trunker.kicad_pcb, coin-trunker.sch]
2021-03-13 HV test board; A bunch of work towards v0.2
    [CoinTestCollect.sch, HVSupply.sch, USBCon.sch, coin-trunker.dsn, coin-trunker.kicad_pcb, coin-trunker.sch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]
2021-03-21 Bunch'o work towards v0.2
    [CoinTestCollect.sch, HVSupply.sch, USBCon.sch, coin-trunker.kicad_pcb, coin-trunker.sch]
2021-03-25 Coin thing v0.2 PCB
    [HVSupply.sch, coin-trunker.kicad_pcb, coin-trunker.sch]
2021-04-11 V0.2 as ordered
    [CoinTestCollect.sch, HVSupply.sch, USBCon.sch, coin-trunker.csv, coin-trunker.kicad_pcb]
2021-04-16 Start work on alternate micro
    [CoinTestCollect.sch, HVSupply.sch, USBCon.sch, coin-trunker.kicad_pcb, coin-trunker.sch, out.csv]
